AlbertoGaudio/CAVEduino/README.md

# CAVEduino
A datalogger for cave environmental monitoring.
A free and open source project developped by Alberto Gaudio and the Greater Houston Grotto. 
## Introduction
CAVEduino is an open source project to build and operate a data-logger to monitor cave environment. The project is based on ESP32 controller and it is studied to be easily transported and deployed in a cave. The hardware selection was studied to fit the purpose containing the costs, make it simple to replace batteries and retrieve data and simple use and handling in cave. The logger can record a data every 30 min for approximately 6 months. This guide is to build a basic data-logger for Temperature, Pressure and Relative Humidity, however the possibilities to add any sort of sensor are limitless.

CAVEduino has been designed by cavers for cavers, therefore one of the main focus was on streamlining the battery swap and data retrieval: you don't need to bring a laptop in cave to download the data, batteries are easy to transport and LED flashing codes provide information on normal operations.

Browse the repository to find your preferred model:
 - CAVEduino v1.0: ESP32-C6
 - CAVEduino v2.0: ESP32-S3

**Carefully read all the instruction. You will build and operate the CAVEduino at your own risk.**

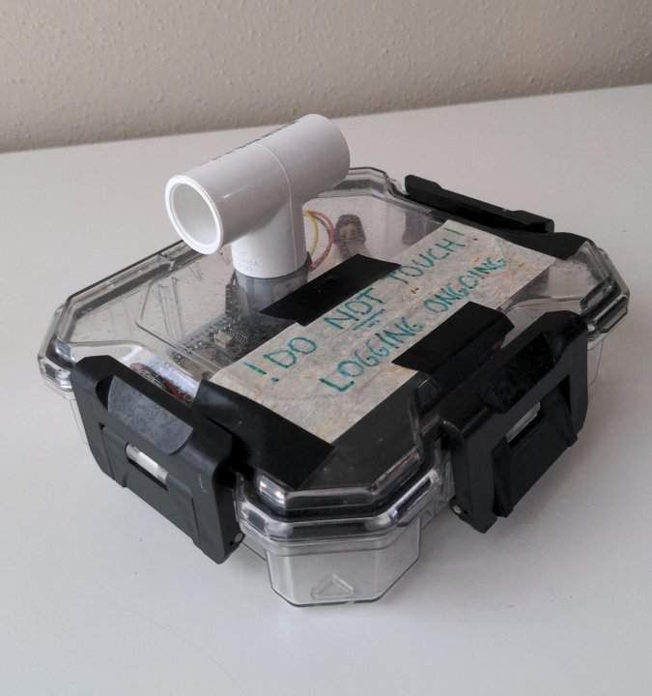
[picture p1: code/outside.jpg]
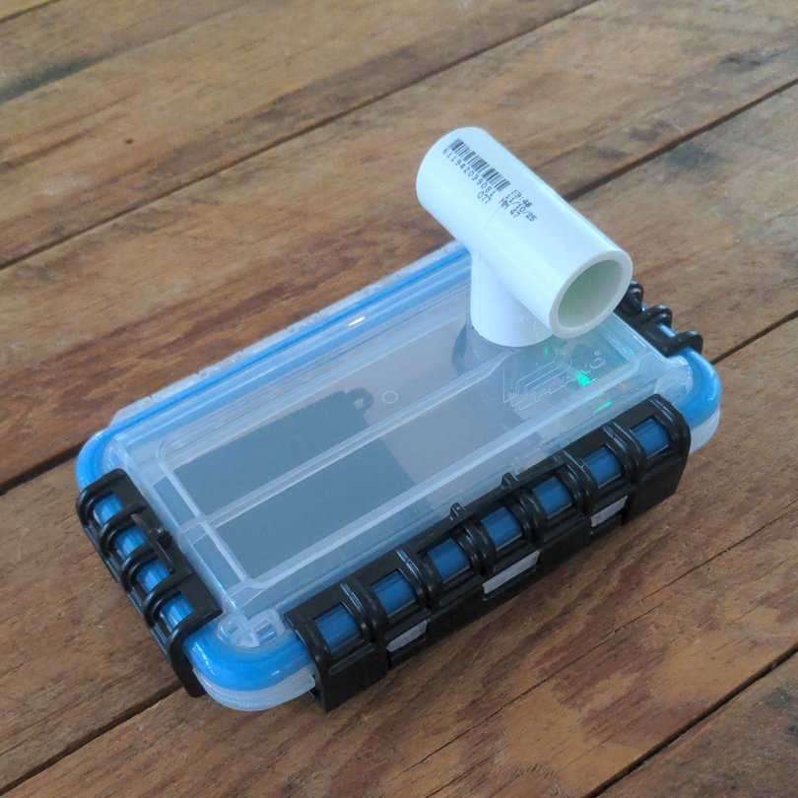
[picture p2: code/CaveDuinoV2-closed_rid.jpeg]
CAVEduino
